BostonUniversitySeniorDesign/21-17-Future-of-Heat/images/ArduinoFunctions.JPG

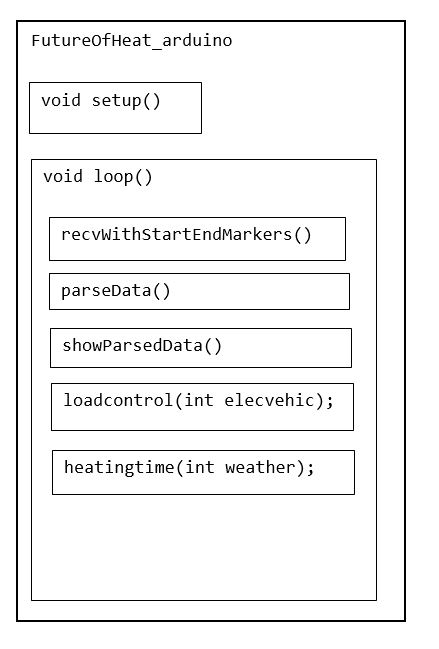
images/ArduinoFunctions.JPG
