BostonUniversitySeniorDesign/21-17-Future-of-Heat/images/cooling towe ran offices.png

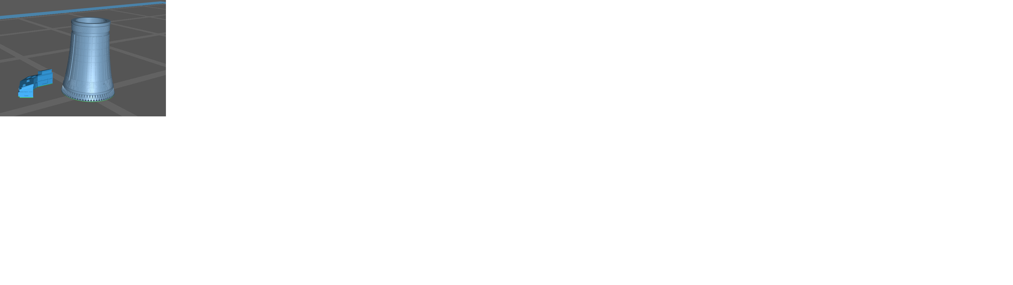
images/cooling towe ran offices.png
