BostonUniversitySeniorDesign/21-17-Future-of-Heat/images/DependencyFlowchart.jpeg

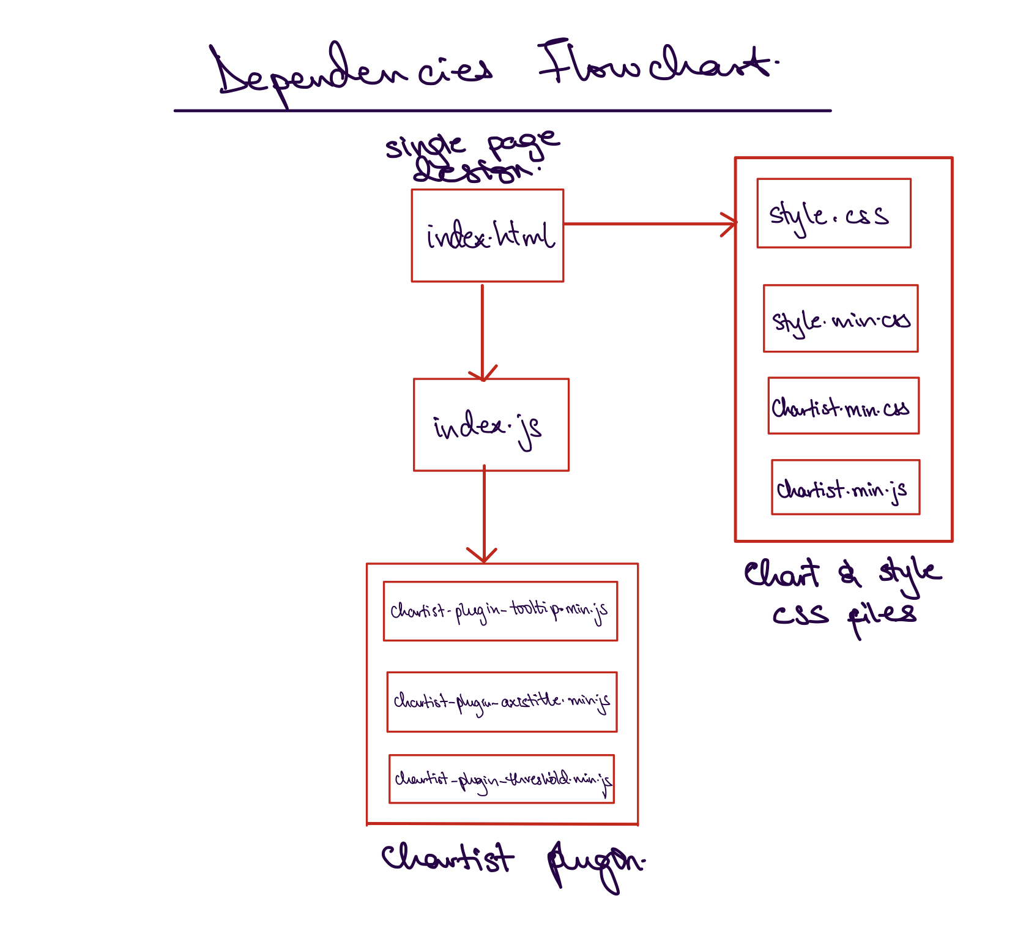
images/DependencyFlowchart.jpeg
