BostonUniversitySeniorDesign/21-17-Future-of-Heat/images/hotel.png

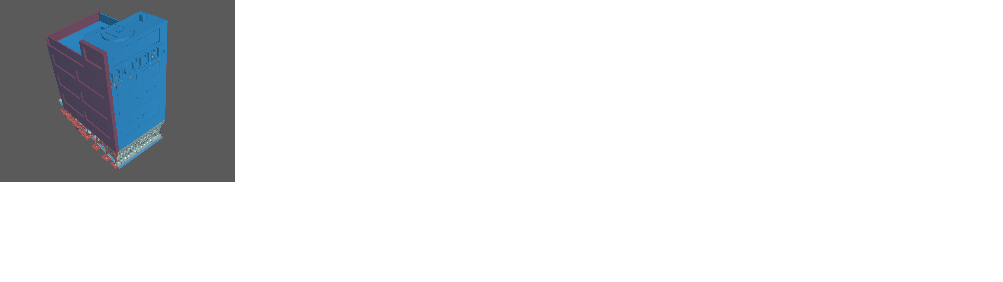
images/hotel.png
