BostonUniversitySeniorDesign/21-17-Future-of-Heat/images/house 1.png

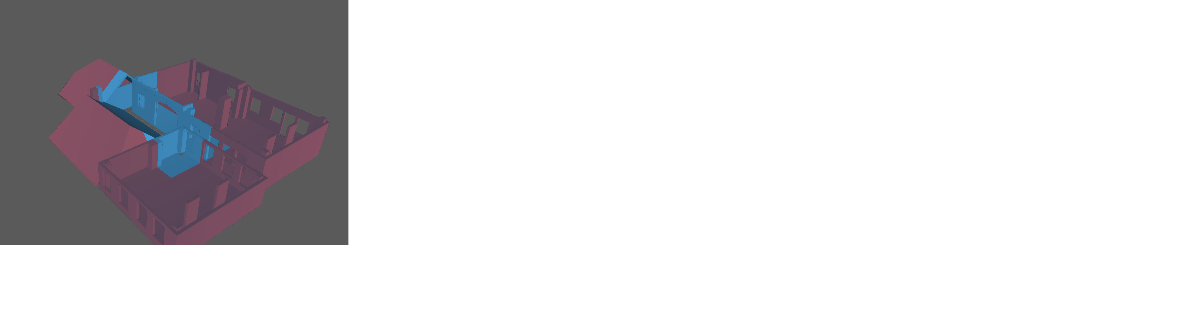
images/house 1.png
