BostonUniversitySeniorDesign/21-17-Future-of-Heat/Resources/BOM - Final.xlsx

Item No. | Item Name | Qty. | Description | Unit Cost | Extended Cost | Vendor Information
1 | SSR Relay | 25 | Toggle switch for load units | $3.10 | $77.50 | https://www.digikey.com/en/products/detail/panasonic-electric-works/AQY210EH/513082
2 | Breadboard PCB | 7 | To assemble the circuitry | $5.85 | $40.92 | https://www.digikey.com/en/products/detail/vector-electronics/8022/565947
3 | 800 Ohm Res | 11 | Models electric heating | $1.46 | $16.03 | https://www.digikey.com/en/products/detail/ohmite/43F800E/823269
4 | 400 Ohm Res | 21 | Models main load | $1.40 | $29.30 | https://www.digikey.com/en/products/detail/vishay-dale/ALSR03400R0JE12/257243
5 | 2400 Ohm Re | 11 | Models electric vehicles | $1.86 | $20.46
6 | 300 Ohm Res | 25 | Current limiter for relay input | $0.80 | $20.00
7 | 120 V - 12 V Transformer | 1 | Steps down the wall socket voltage to 12 volts | $16.35 | $16.35 | https://www.digikey.com/en/products/detail/triad-magnetics/TCT40-03E07K/2638188
8 | Power Cord | 1 | Draws power from the wall socket | $8.95 | $8.95 | https://www.amazon.com/Pinfox-Replacement-Pigtail-Universal-Appliance/dp/B07RQNZJB7
9 | 2 x 4 Wood Planks | 4 | Used to create the diorama base | $2.39 | $9.56
10 | Insulation Foam | 2 | Used to fill in gaps in the diorama base for a smooth surface | $25.00 | $50.00
11 | SLA Resin | 3 | Create diorama buildings | $37.00 | $111.00
12 | Arduino Mega | 1 | Microcontroller for LEDs + relays | $38.50 | $38.50
13 | HUZZAH ESP8266 | 1 | Wifi Communication | $19.95 | $19.95
14 | Demultiplexer | 8 | Multiplex Arduino signals | $0.47 | $3.75
15 | Red/Blue LED | 12 | Indicates homes heating | $0.41 | $4.92
16 | Red/Green LED | 12 | Indicates electric/gas heating | $0.31 | $3.66
17 | 330 Ohm Res | 48 | Current limiter for LEDs | $0.10 | $4.88
Total Cost |  |  |  |  | $475.73
