BostonUniversitySeniorDesign/21-17-Future-of-Heat/(commit log)

2021-05-01 Create 15mm buildings.zip
2021-05-01 resource commit
    [BOM - Final.xlsx]
